Joe-Templet/STJ-Designs/Projects/2003-v1/WaferLayout_Chips_Chosen.pdf

2x3 - 196
3x3 - 130
10x10 - 44
1] | (2) | 12mm from center
2a] (6+3) (2/3)mm pitch (above/below) center 2b] (32) 3mm pitch
3] (8x4) 10mm x 10mm pitch (maybe 2 steps?)
