Joe-Templet/STJ-Designs/Reference/Design/32-130-B.png

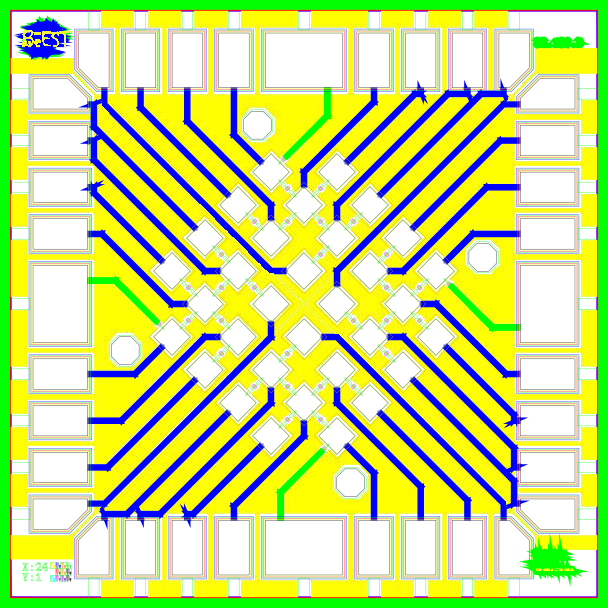
Reference/Design/32-130-B.png
