Joe-Templet/STJ-Designs/Reference/Design/128-200-B.png

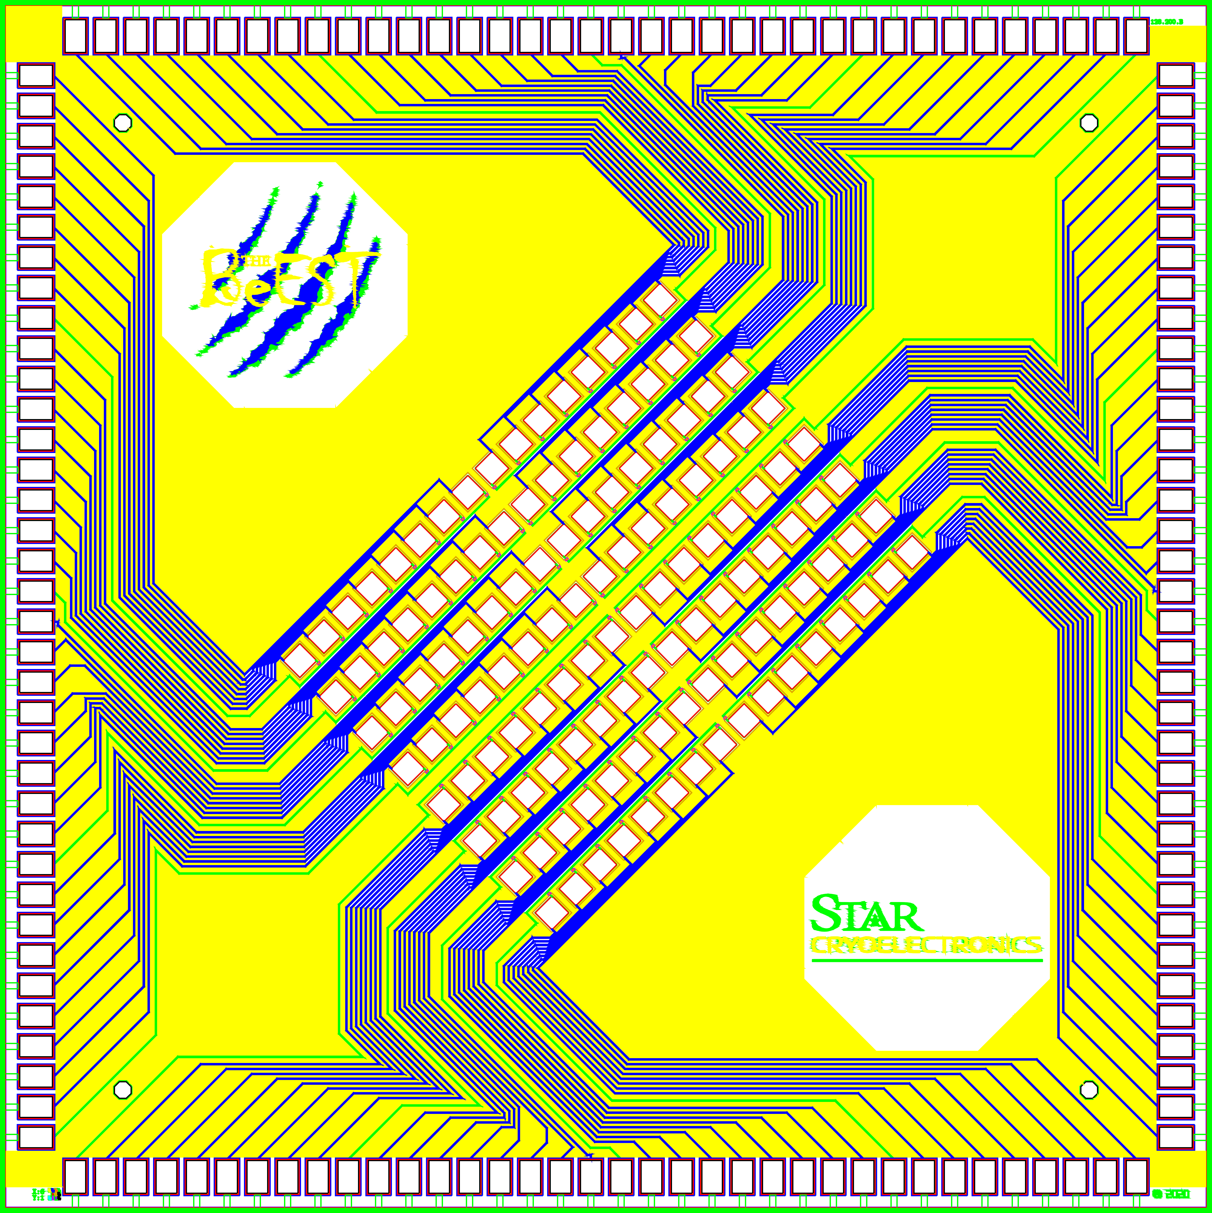
Reference/Design/128-200-B.png
