Joe-Templet/STJ-Designs/Reference/Design/TC-B.png

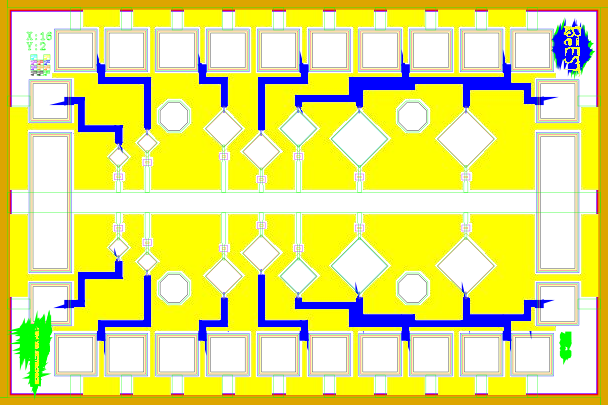
Reference/Design/TC-B.png
