Joe-Templet/STJ-Designs/Reference/Cell List.xlsx

Name | Prefix | Multiplicity | Subsystem 1 | Subsystem 2 | Core | Size | Feature | C1 | C2 | C3 | C4 | C5 | Feature Set | Notes
$128_70 | $ | 128 |  |  |  | 70 |  | 70 | 70 | 70 | 70 | 128_70 | A | (A)bsorber on pixels
$128_70A | $ | 128 |  |  |  | 70 | A | 70A | 70A | 70A | 70A | 128_70A | B | (B)eEST Logo on Chip
$128_70B | $ | 128 |  |  |  | 70 | B | 70B | 70B | 70B | 70B | 128_70B | C | Both A + B
$128_70C | $ | 128 |  |  |  | 70 | C | 70C | 70C | 70C | 70C | 128_70C | E | (Not Used) NO Membrane (E)tch
$128_130 | $ | 128 |  |  |  | 130 |  | 130 | 130 | 130 | 130 | 128_130 | F | (Not Used) NO (F)ield Area Au Fill
$128_130A | $ | 128 |  |  |  | 130 | A | 130A | 130A | 130A | 130A | 128_130A | P | (Not Used) SiO2 (P)atches
$128_130B | $ | 128 |  |  |  | 130 | B | 130B | 130B | 130B | 130B | 128_130B | S | (Not Used) Full (S)iO2 Edge Coverage
$128_130C | $ | 128 |  |  |  | 130 | C | 130C | 130C | 130C | 130C | 128_130C
$128_200 | $ | 128 |  |  |  | 200 |  | 200 | 200 | 200 | 200 | 128_200
$128_200A | $ | 128 |  |  |  | 200 | A | 200A | 200A | 200A | 200A | 128_200A
$128_200B | $ | 128 |  |  |  | 200 | B | 200B | 200B | 200B | 200B | 128_200B
$128_200C | $ | 128 |  |  |  | 200 | C | 200C | 200C | 200C | 200C | 128_200C
$32_70 | $ | 32 |  |  |  | 70 |  | 70 | 70 | 70 | 70 | 32_70
$32_70A | $ | 32 |  |  |  | 70 | A | 70A | 70A | 70A | 70A | 32_70A
$32_70B | $ | 32 |  |  |  | 70 | B | 70B | 70B | 70B | 70B | 32_70B
$32_70C | $ | 32 |  |  |  | 70 | C | 70C | 70C | 70C | 70C | 32_70C
$32_130 | $ | 32 |  |  |  | 130 |  | 130 | 130 | 130 | 130 | 32_130
$32_130A | $ | 32 |  |  |  | 130 | A | 130A | 130A | 130A | 130A | 32_130A
$32_130B | $ | 32 |  |  |  | 130 | B | 130B | 130B | 130B | 130B | 32_130B
$32_130C | $ | 32 |  |  |  | 130 | C | 130C | 130C | 130C | 130C | 32_130C
$32_200 | $ | 32 |  |  |  | 200 |  | 200 | 200 | 200 | 200 | 32_200
$32_200A | $ | 32 |  |  |  | 200 | A | 200A | 200A | 200A | 200A | 32_200A
$32_200B | $ | 32 |  |  |  | 200 | B | 200B | 200B | 200B | 200B | 32_200B
$32_200C | $ | 32 |  |  |  | 200 | C | 200C | 200C | 200C | 200C | 32_200C
$TC | $ | TC |  |  |  |  |  |  |  |  |  | TC
$TC_B | $ | TC |  |  |  |  | B | B | B | B | B | TC_B
_128PADS | _ | 128 | PADS |  |  |  |  |  |  |  | PADS | 128PADS
_32PADS | _ | 32 | PADS |  |  |  |  |  |  |  | PADS | 32PADS
_128_PAD | _ | 128 |  |  | PAD |  |  |  | PAD | PAD | PAD | 128_PAD
_128_PAD | _ | 128 |  |  | PAD |  |  |  | PAD | PAD | PAD | 128_PAD
_ | _
_ | _
_ | _
_ | _
_ | _
_ | _
_ | _
_ | _
_ | _
_ | _
_ | _
_ | _
_ | _
_ | _
_ | _
_ | _
_ | _
_ | _
_ | _
_ | _
_ | _
_ | _
_ | _
_ | _
_ | _
_ | _
_ | _
_ | _
_ | _
_ | _
_ | _
_ | _
_ | _
_ | _
_ | _
_ | _
_ | _
_ | _
_ | _
