Joe-Templet/STJ-Designs/Reference/Fabrication/SAEP/Test Chip.dxf

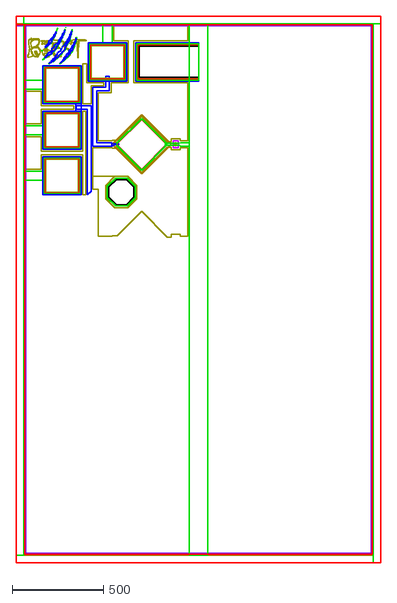
[picture p8: CAD file, 2024-06-13]
Reference/Fabrication/SAEP/Test Chip.dxf
2000.0 x 3000.0
