Joe-Templet/STJ-Designs/KLayoutEditor/Masks-Collimators.dxf

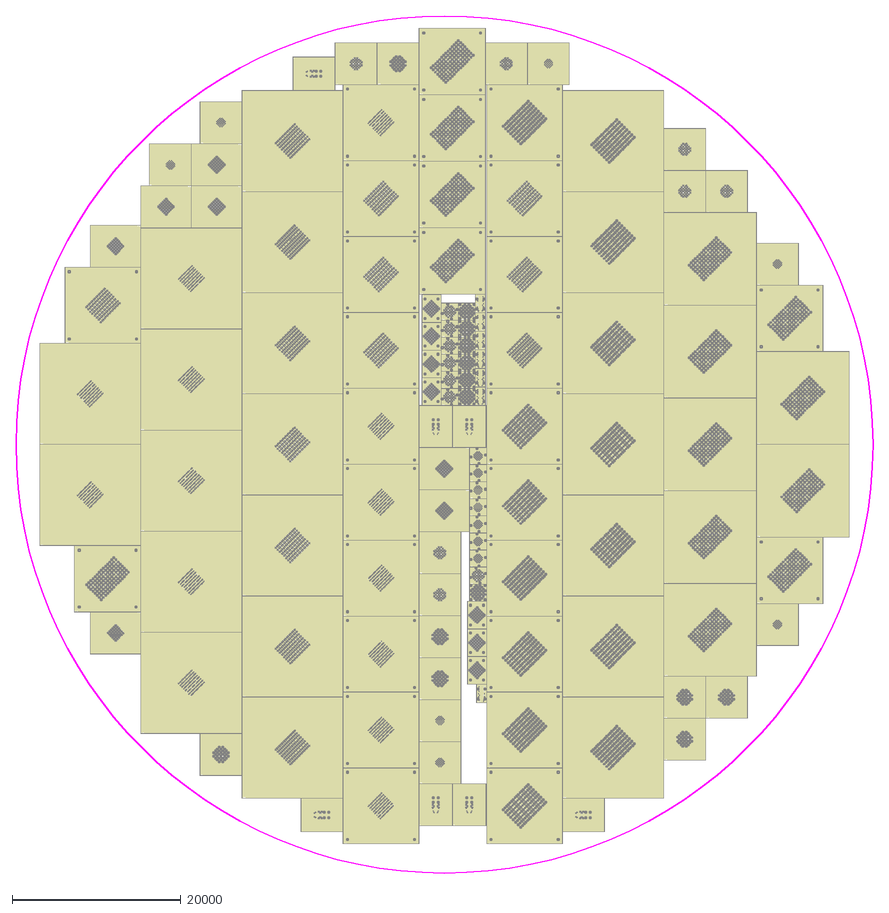
[picture p9: CAD file, 2024-06-13]
KLayoutEditor/Masks-Collimators.dxf
101600.0 x 101600.0
