Joe-Templet/STJ-Designs/(list of files, cad)

Other CAD files:
AutoCAD/Masks-Collimators.dwg
KLayoutEditor/Cells-Fabrication.dxf
AutoCAD/Masks-Encapsulation.dwg
AutoCAD/Cells-Fabrication.dwg
AutoCAD/Numbering.dwg
AutoCAD/STARCryo.dwg
AutoCAD/Cells-Collimators.dwg
Reference/Fabrication/SAEP/Test Chip.dwg
