Joe-Templet/STJ-Designs/Reference/Fabrication/Tolerances/STJ-XS_Tolerances.md

---
aliases: 
tags: 
---
# STJ-XS_Tolerances

#todo
- [ ] Add Nb plug and plug width (20 $\mu$m)
