Joe-Templet/STJ-Designs/Reference/Fabrication/Tolerances/STJ-XS_Tolerances.png.md

---
aliases: 
tags: 
type: file-note
cdate:  2023-10-09
idate:  2024-02-28
source: ""
---
# STJ-XS_Tolerances.png

![[6_History/BeEST-3DEV-Al_STJ/Planning/Tolerance Details/STJ-XS_Tolerances.png]]

## Backlinks

%% Points to the backlinks of the non-markdown file itself. Works excellent with images, need to test on any data type including those with possible editability %%

```dataview
table
where contains(file.outlinks, link(replace(this.file.path,".md","")))
where file.link != this.file.link
```
