Joe-Templet/STJ-Designs/Reference/Fabrication/SAEP/GDS Data/GDS1 Plug.jpg

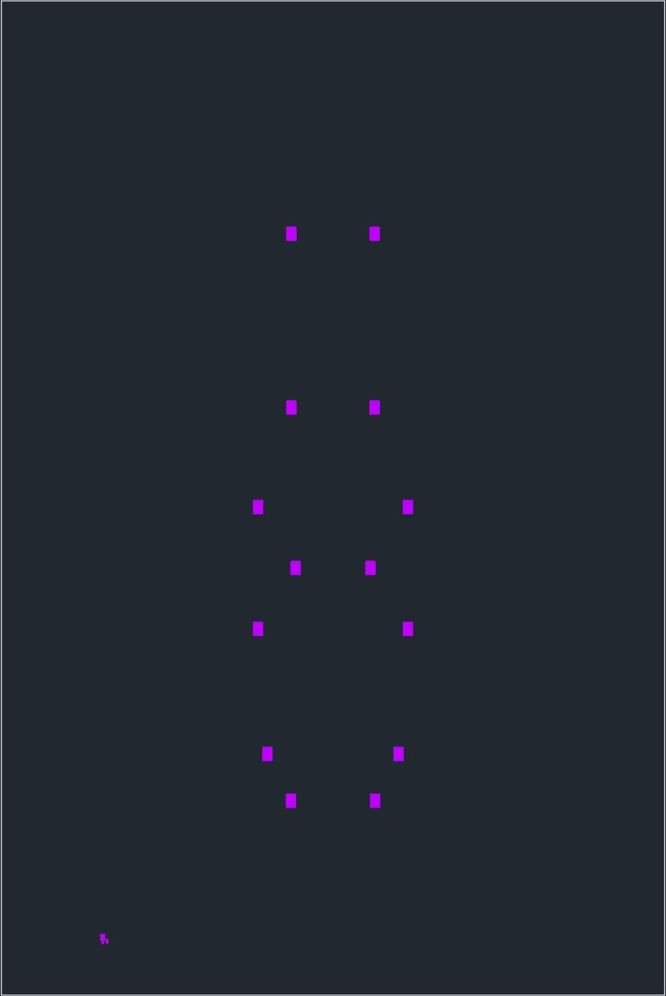
Reference/Fabrication/SAEP/GDS Data/GDS1 Plug.jpg
