Joe-Templet/STJ-Designs/Reference/Fabrication/SAEP/GDS Data/GDS3 Base.jpg

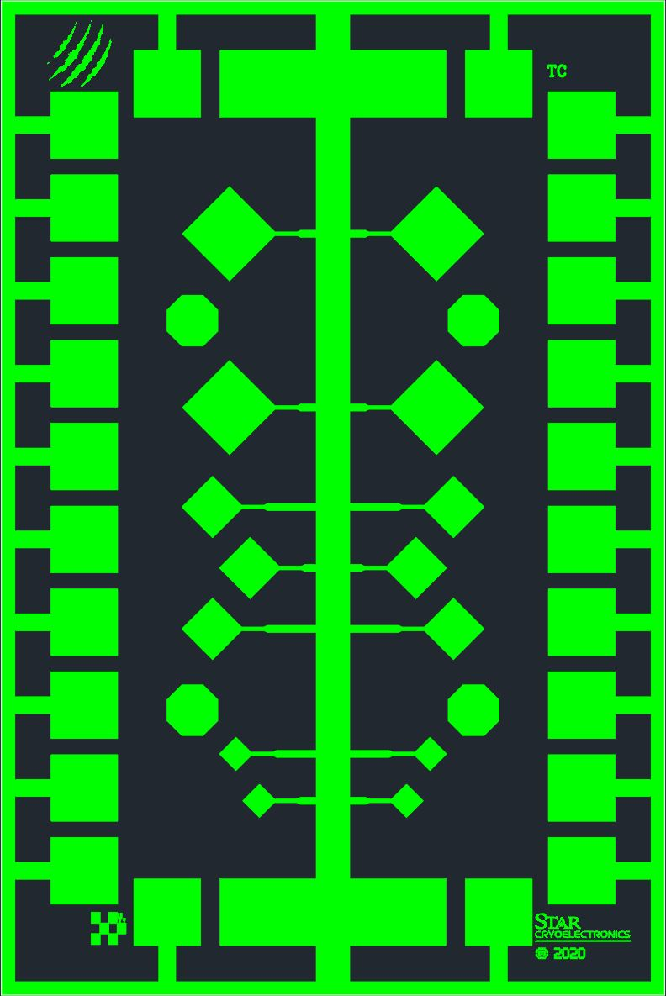
Reference/Fabrication/SAEP/GDS Data/GDS3 Base.jpg
