Joe-Templet/STJ-Designs/Reference/Fabrication/SAEP/GDS Data/GDS4 CNTR.jpg

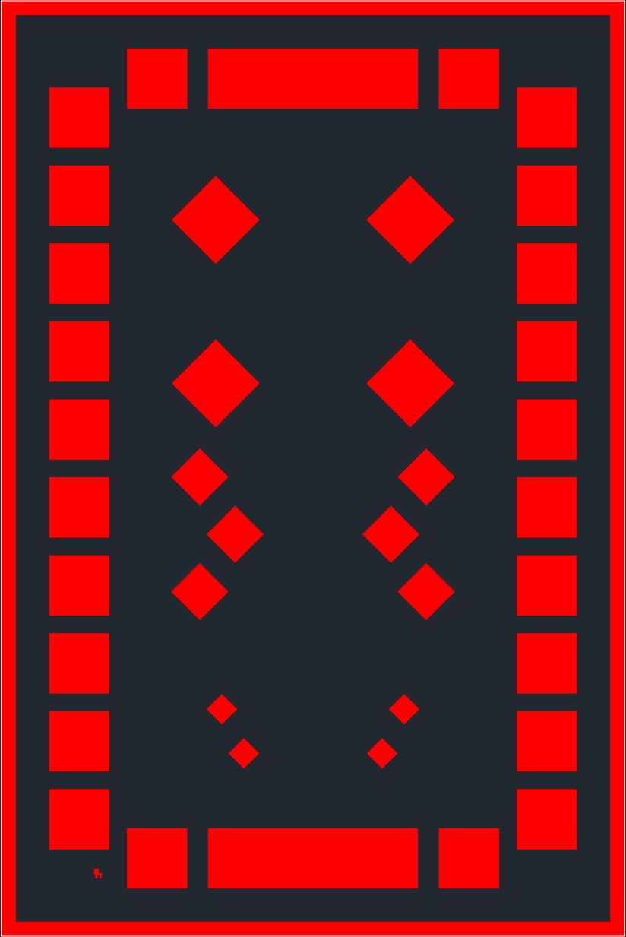
Reference/Fabrication/SAEP/GDS Data/GDS4 CNTR.jpg
