Joe-Templet/STJ-Designs/Reference/Fabrication/SAEP/GDS Data/GDS7 DE.jpg

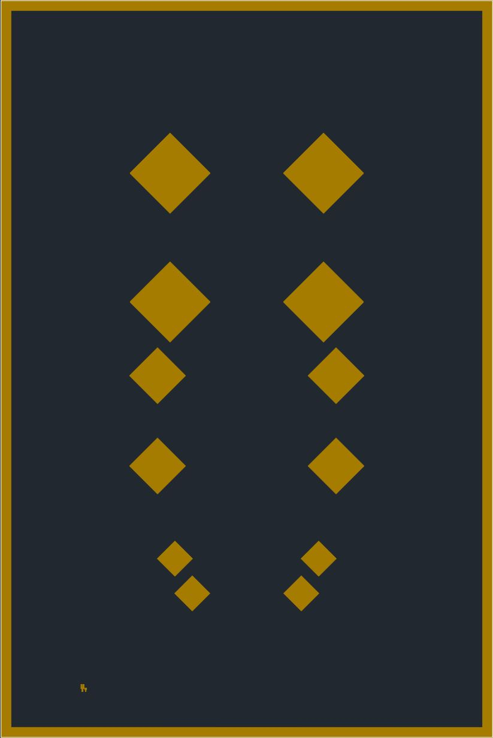
Reference/Fabrication/SAEP/GDS Data/GDS7 DE.jpg
