Joe-Templet/STJ-Designs/Reference/Fabrication/SAEP/GDS Data/GDS8 Wire.jpg

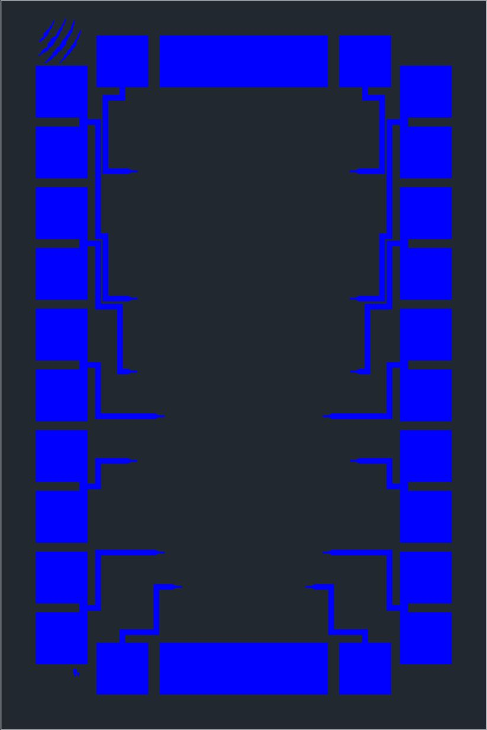
Reference/Fabrication/SAEP/GDS Data/GDS8 Wire.jpg
