Joe-Templet/STJ-Designs/Reference/Fabrication/SAEP/GDS Data/GDS9 Cont.jpg

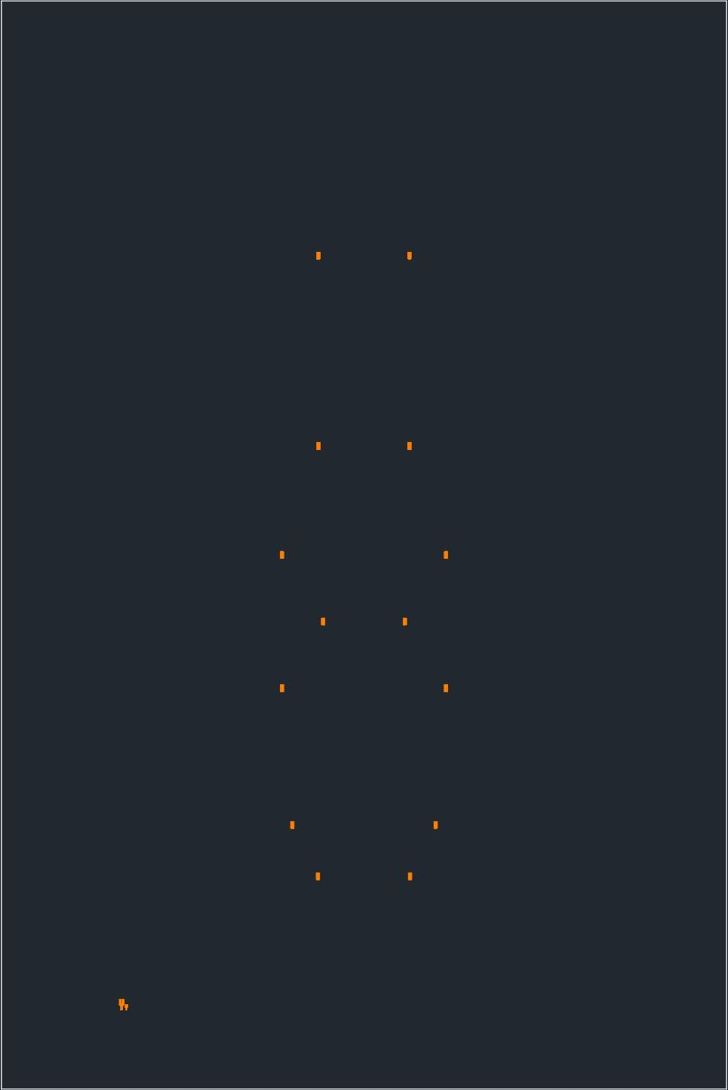
Reference/Fabrication/SAEP/GDS Data/GDS9 Cont.jpg
