Joe-Templet/STJ-Designs/Reference/Fabrication/SAEP/GDS Data/GDS10 ABS.jpg

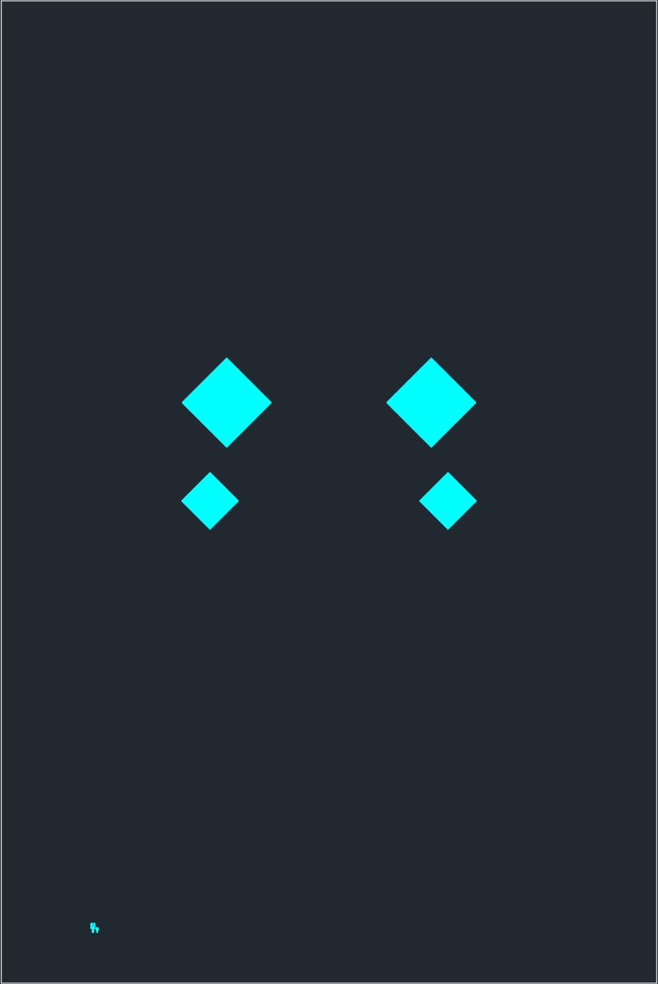
Reference/Fabrication/SAEP/GDS Data/GDS10 ABS.jpg
