Joe-Templet/STJ-Designs/Reference/Fabrication/SAEP/GDS Data/GDS12 Etch.jpg

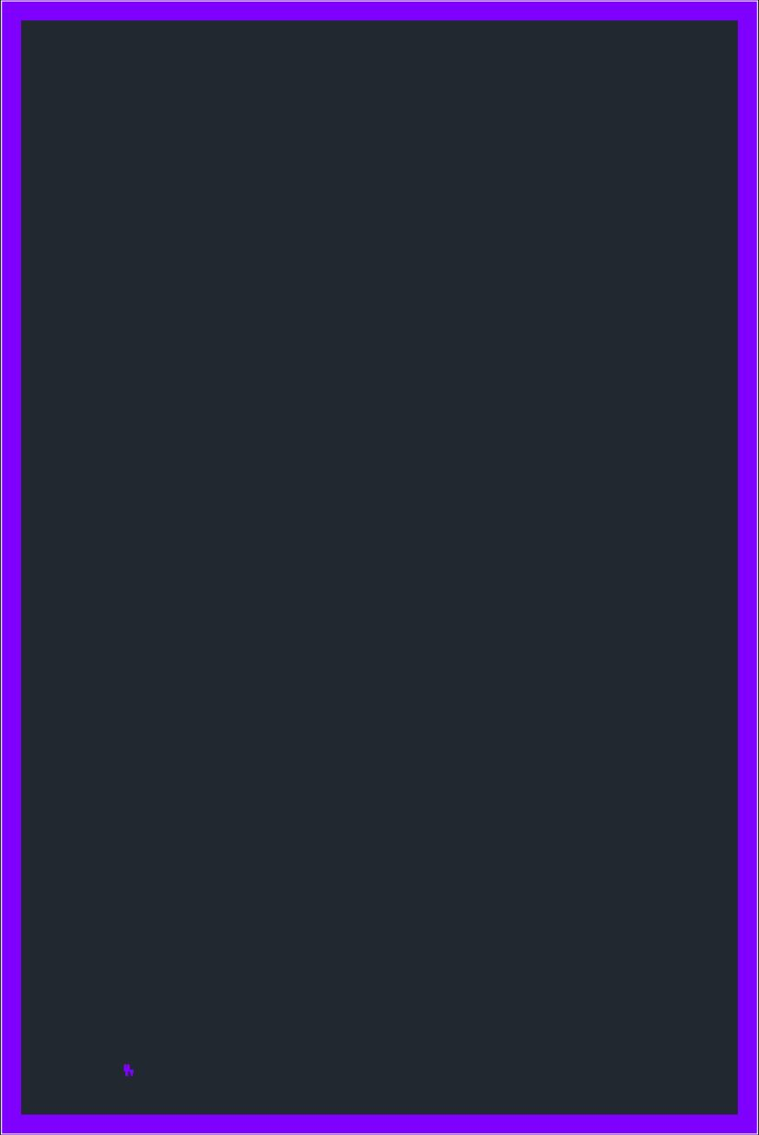
Reference/Fabrication/SAEP/GDS Data/GDS12 Etch.jpg
