Joe-Templet/STJ-Designs/Reference/Fabrication/SAEP/GDS Data/GDS14 Au.jpg

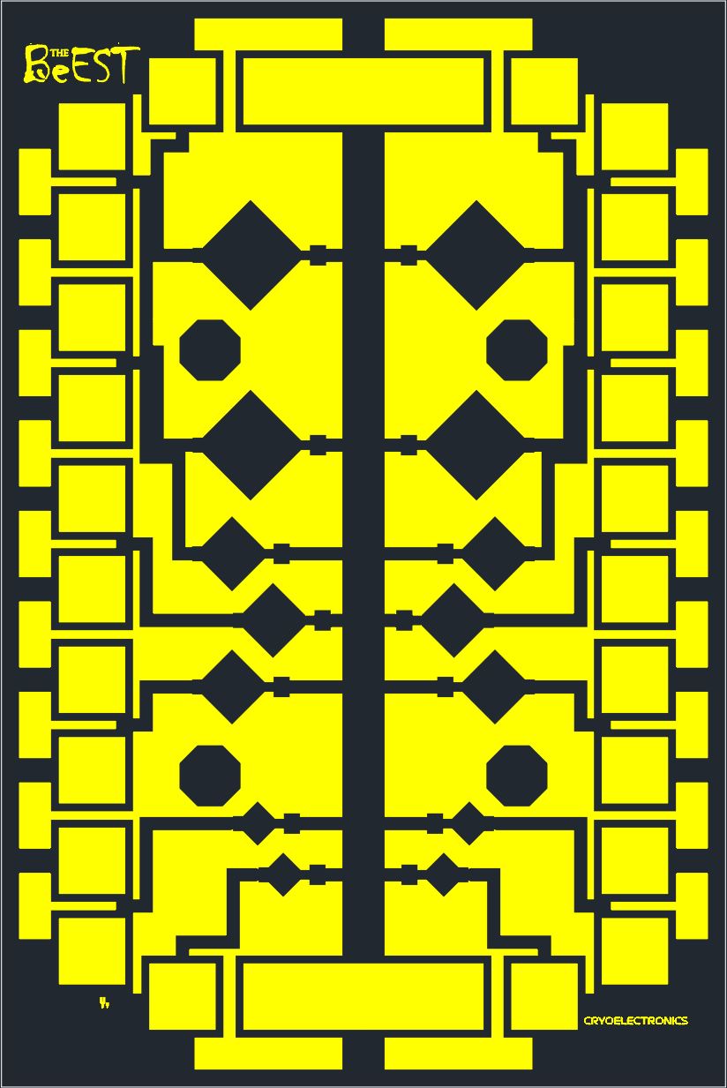
Reference/Fabrication/SAEP/GDS Data/GDS14 Au.jpg
