Joe-Templet/STJ-Designs/Reference/Fabrication/SAEP/GDS Data/GDS18+15 SU8+PVIA.jpg

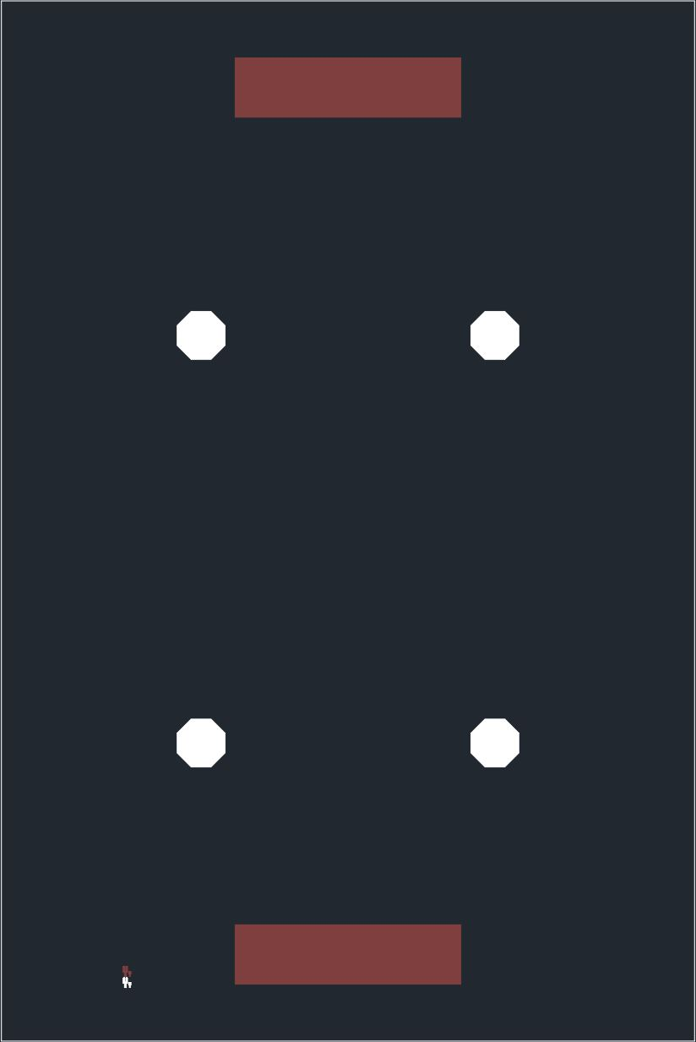
Reference/Fabrication/SAEP/GDS Data/GDS18+15 SU8+PVIA.jpg
