Joe-Templet/STJ-Designs/Reference/Fabrication/SAEP/GDS Data/GDS50 SiO2.jpg

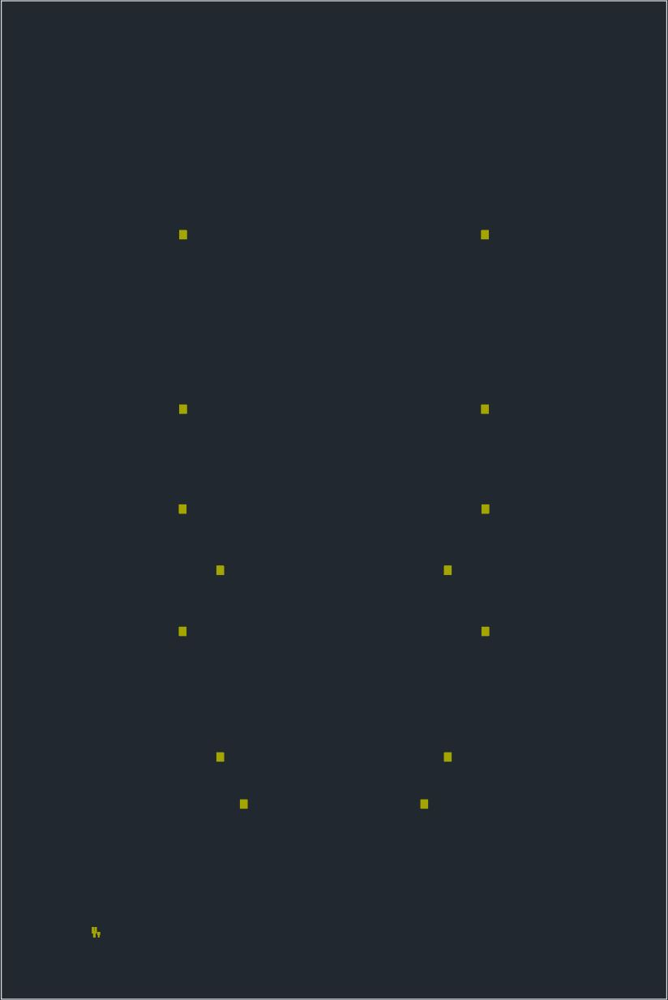
Reference/Fabrication/SAEP/GDS Data/GDS50 SiO2.jpg
