Joe-Templet/STJ-Designs/Projects/2003-v1/128_130_Full.pdf

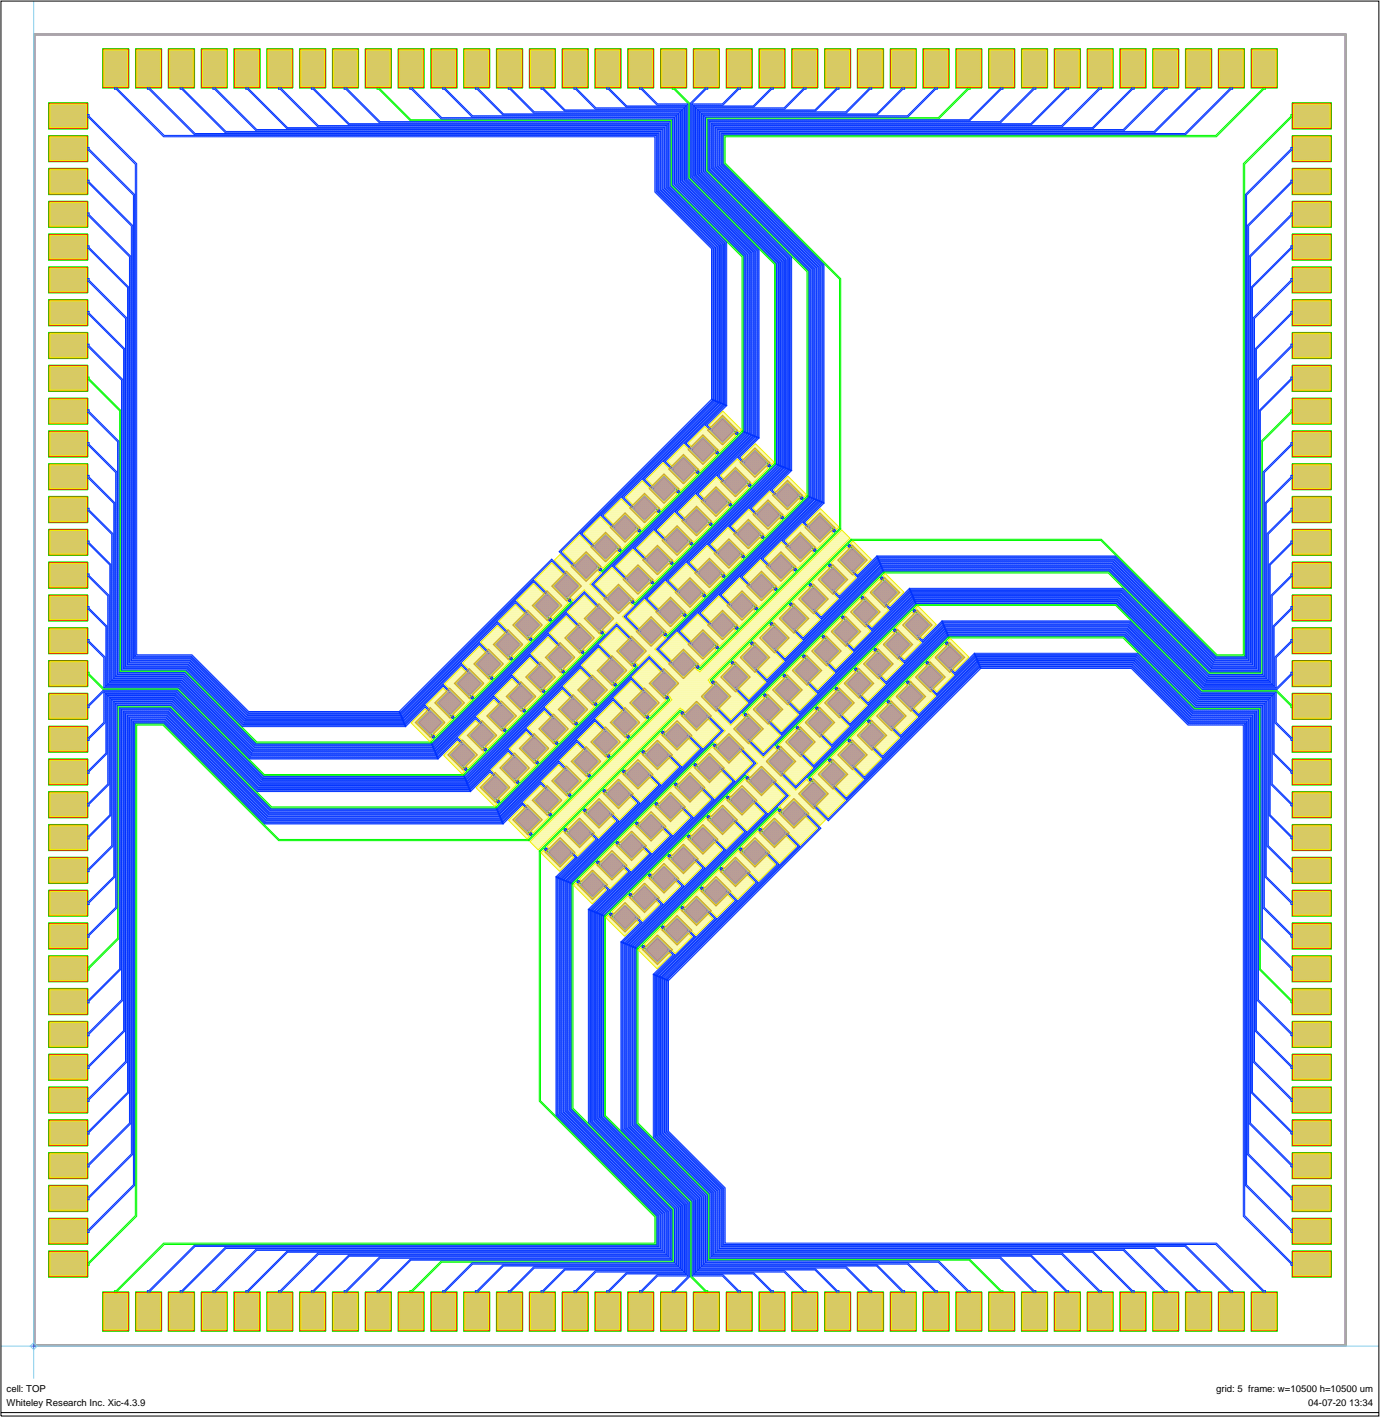
[picture p21: page 1]
cell: TOP; grid: 5 frame: w=10500 h=10500 um; Whiteley Research Inc. Xic-4.3.9
