Joe-Templet/STJ-Designs/Projects/2003-v1/128_70_Full.pdf

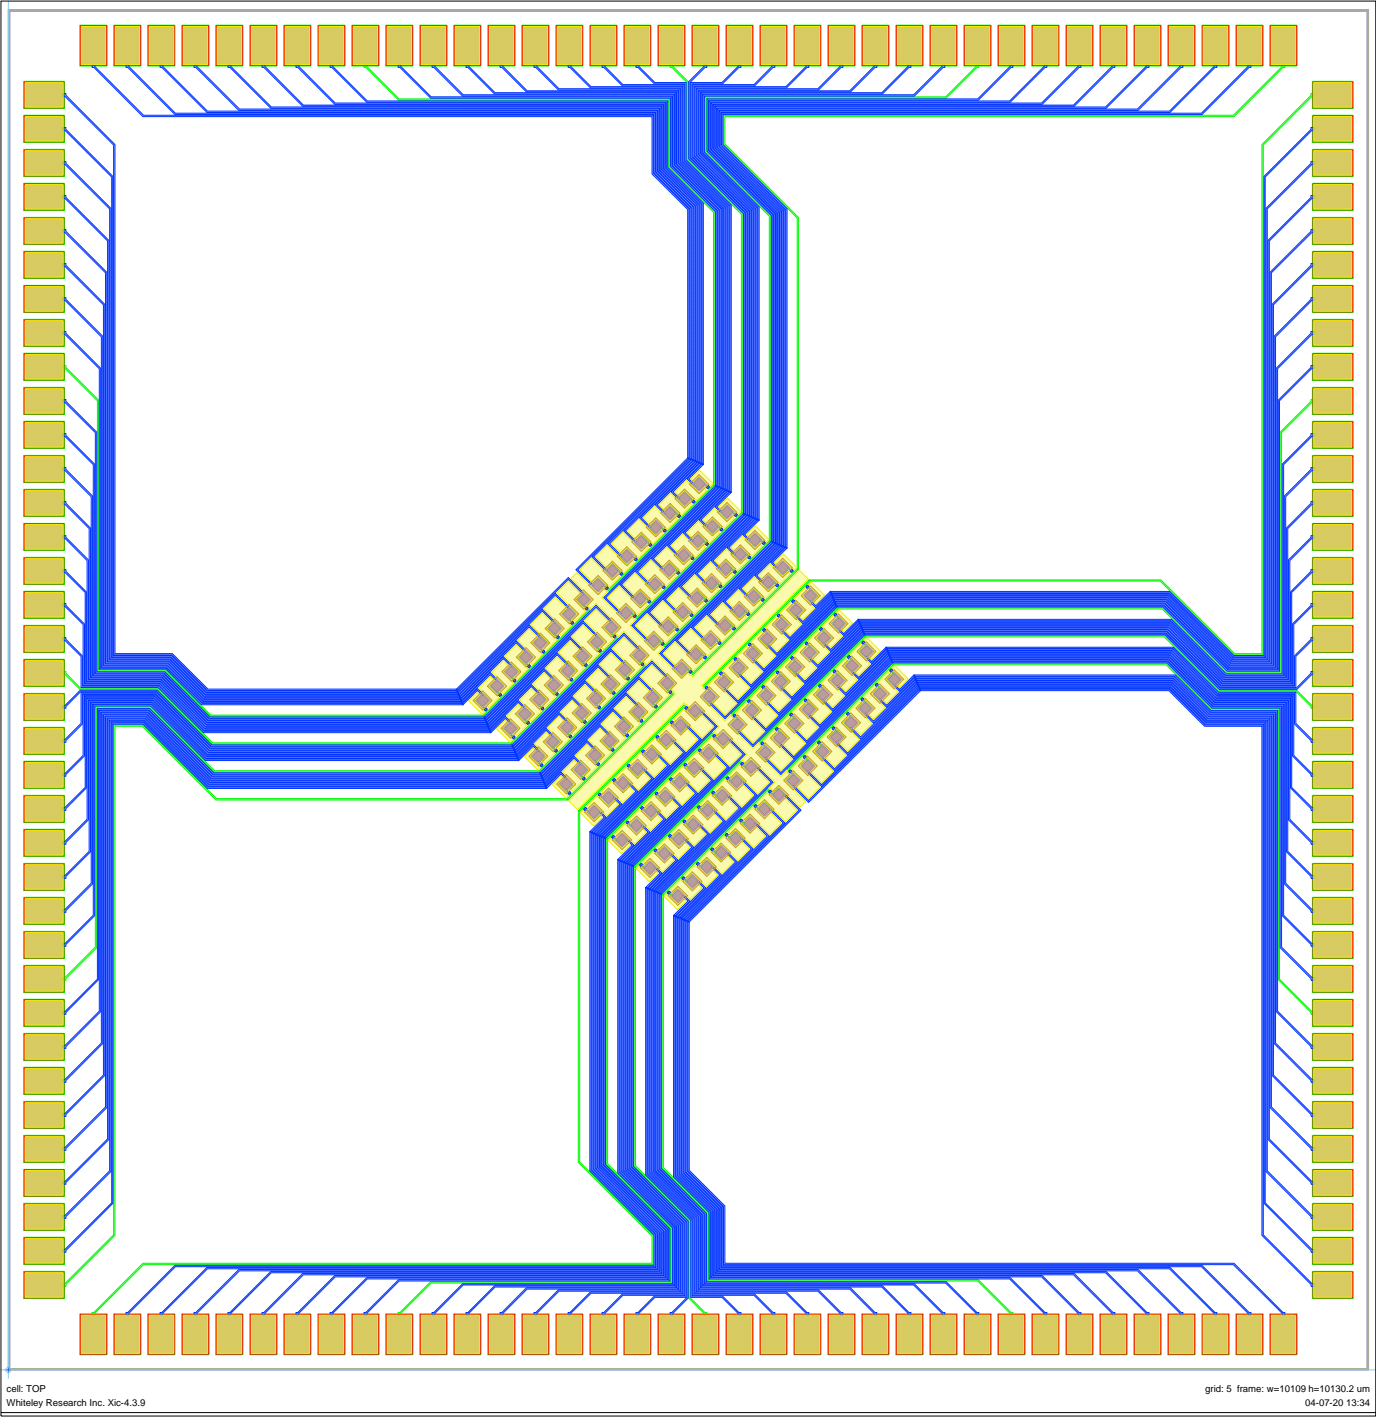
[picture p22: page 1]
cell: TOP; grid: 5 frame: w=10109 h=10130.2 um; Whiteley Research Inc. Xic-4.3.9
