Joe-Templet/STJ-Designs/Projects/2003-v1/36_130.pdf

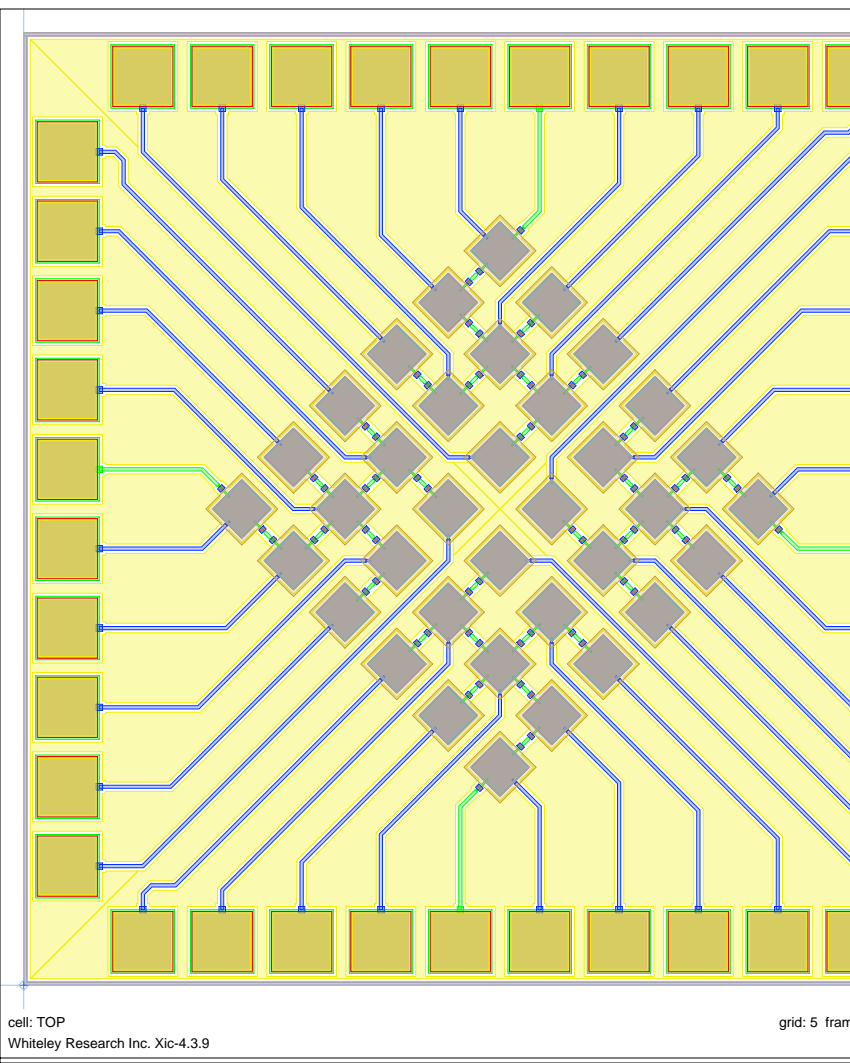
[picture p23: page 1]
cell: TOP; grid: 5 frame: w=3150 h=3150 um

Whiteley Research Inc. Xic-4.3.9
