Joe-Templet/STJ-Designs/Projects/2003-v1/36_70.pdf

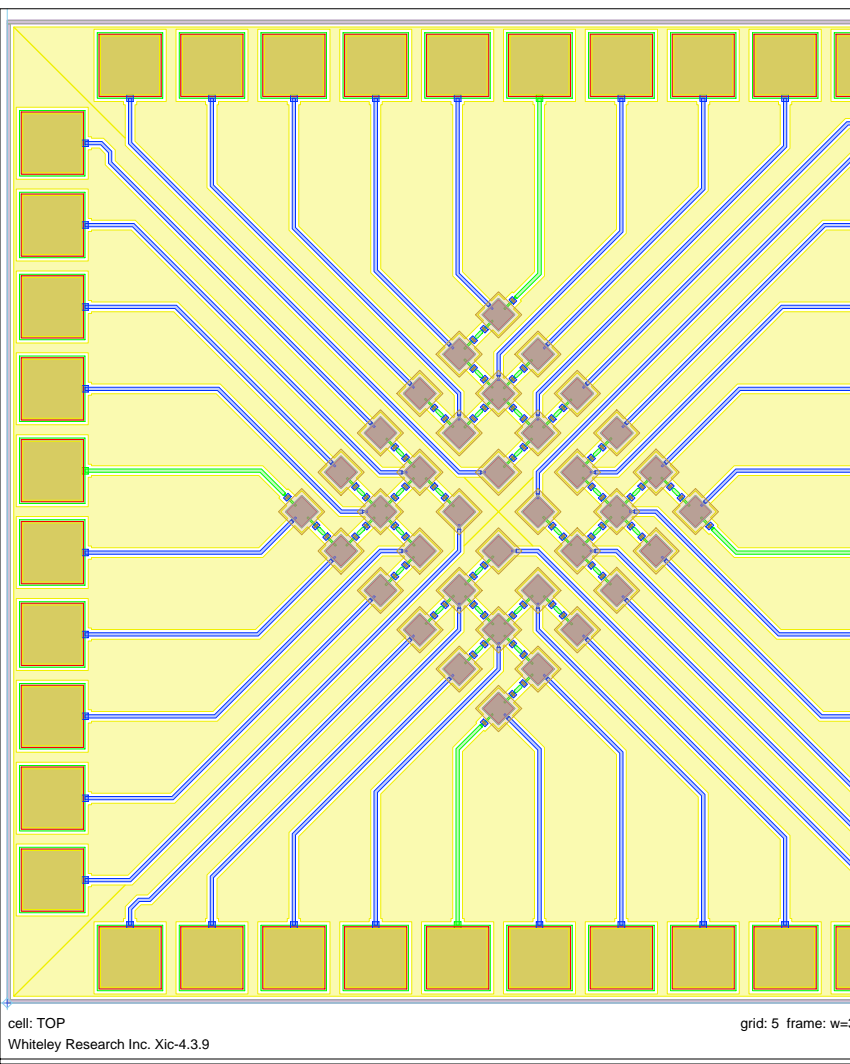
[picture p24: page 1]
cell: TOP; grid: 5 frame: w=3053.27 h=3057.67 um

Whiteley Research Inc. Xic-4.3.9
