Joe-Templet/STJ-Designs/Projects/2003-v1/Cell-TC-Fab.pdf

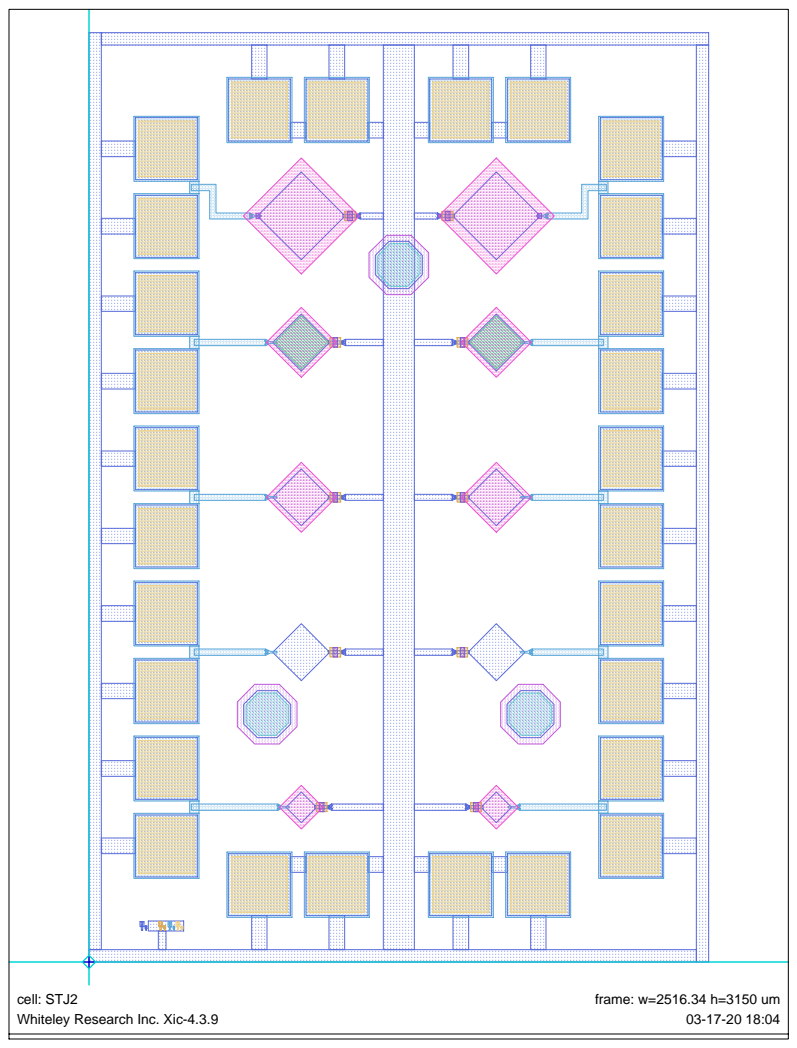
[picture p27: page 1]
cell: STJ2; frame: w=2516.34 h=3150 um; Whiteley Research Inc. Xic-4.3.9
