Joe-Templet/STJ-Designs/Projects/2003-v1/TC_Draft_2.pdf

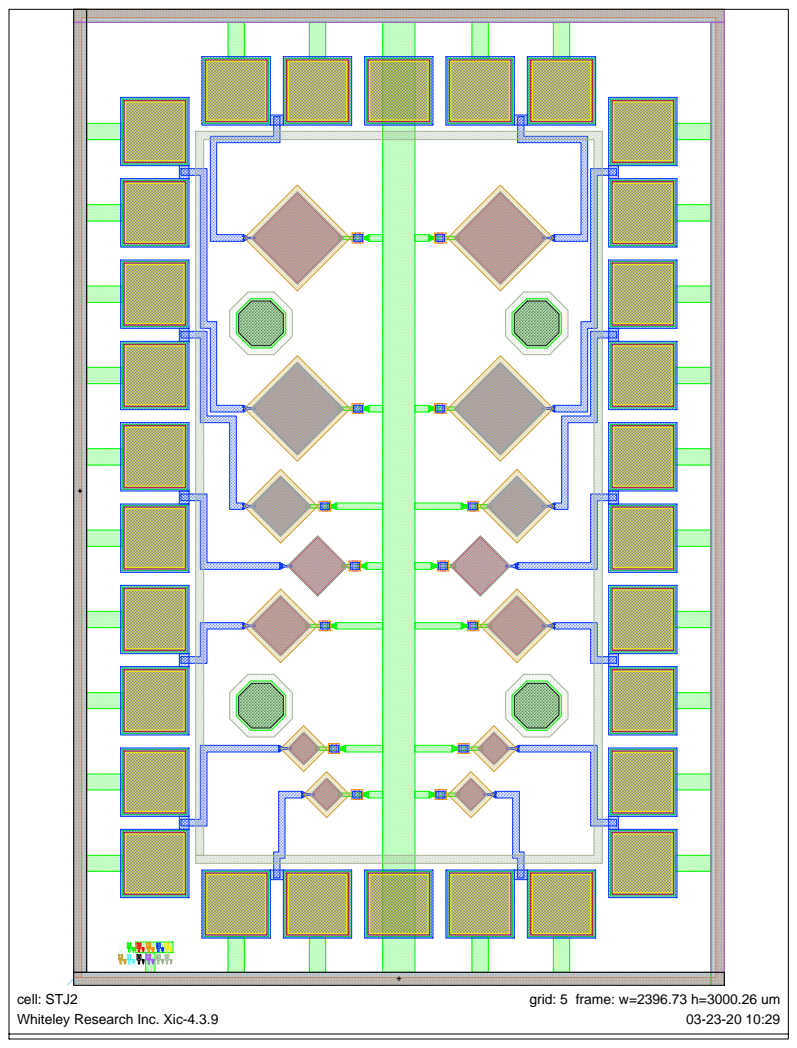
[picture p28: page 1]
cell: STJ2; grid: 5 frame: w=2396.73 h=3000.26 um; Whiteley Research Inc. Xic-4.3.9
