Joe-Templet/STJ-Designs/Projects/2003-v1/TC_Draft_2_Col.pdf

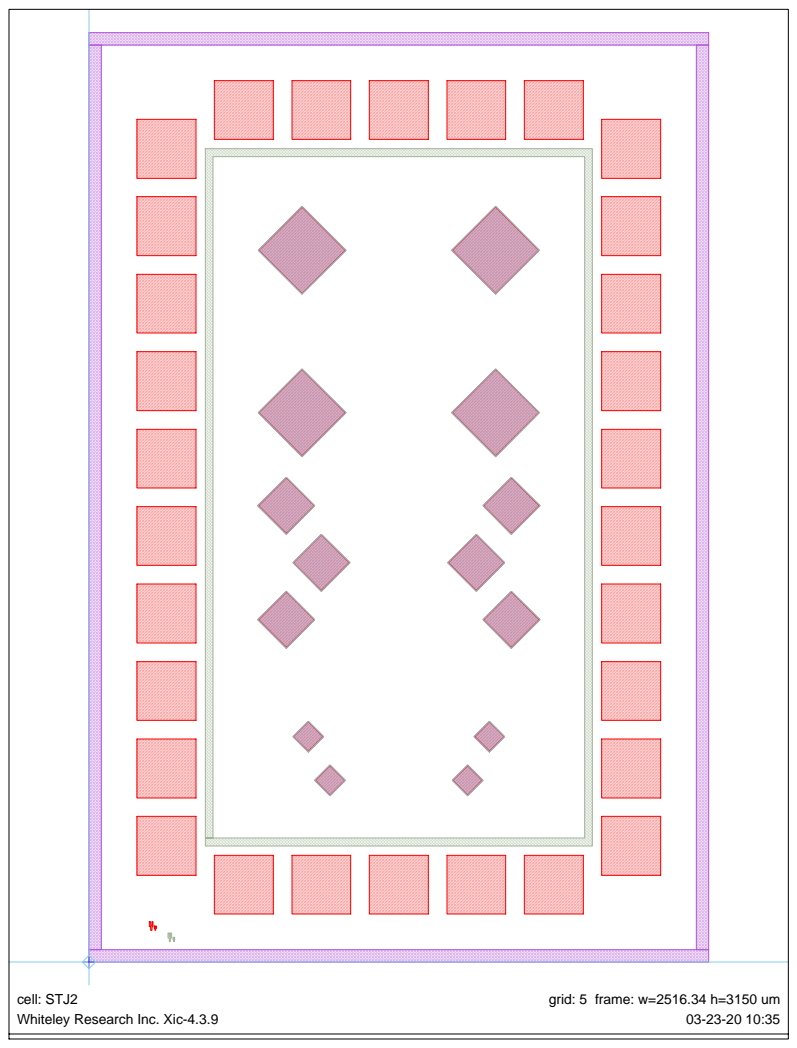
[picture p29: page 1]
cell: STJ2; grid: 5 frame: w=2516.34 h=3150 um; Whiteley Research Inc. Xic-4.3.9
