Joe-Templet/STJ-Designs/Projects/2003-v1/Array_128_70.pdf

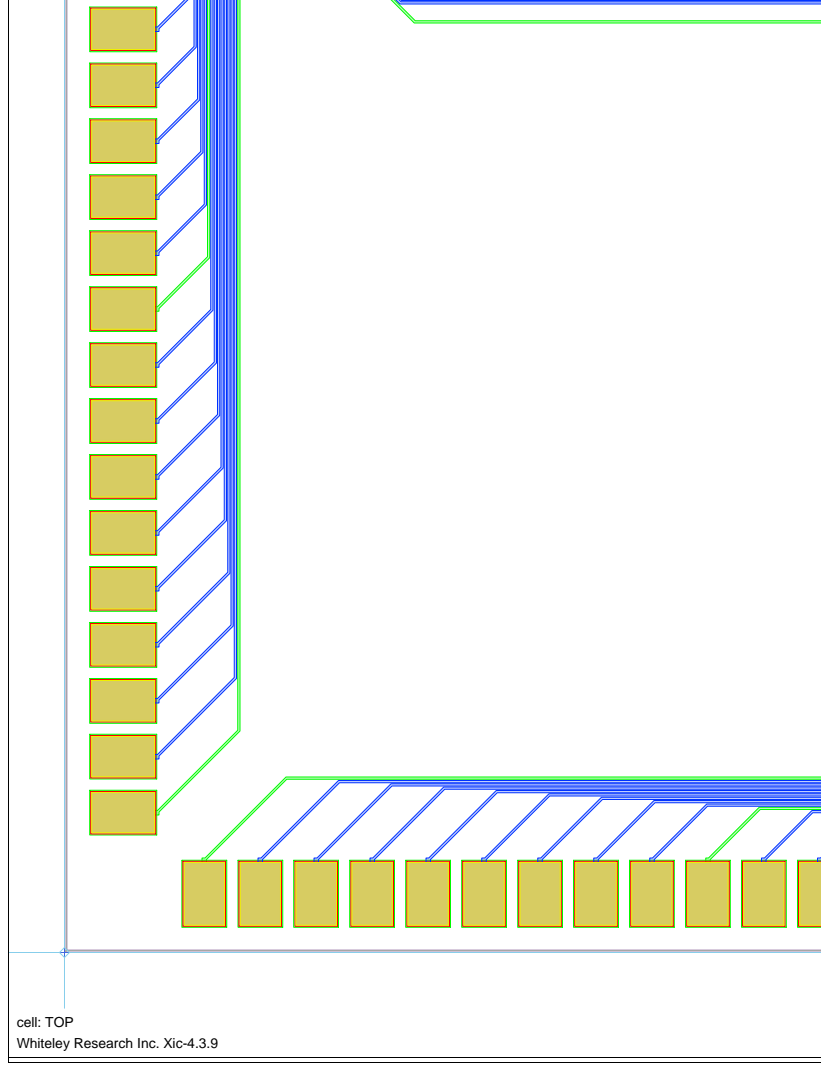
[picture p32: page 1]

cell: TOP
Whiteley Research Inc. Xic-4.3.9
