Joe-Templet/STJ-Designs/(commit log)

2024-06-13 Second Commit
    [Cell List.xlsx, Cells-Collimators.dwg, Cells-Fabrication.dwg, Cells-Fabrication.dxf, Masks-Collimators.dwg, Masks-Collimators.dxf, Masks-Encapsulation.dwg, Numbering.dwg]
2024-06-13 Outline of Quadrant Wires
2024-06-18 quadrant signal wires done (6-18-24)
2024-06-18 Trace is Donegit status
2024-06-19 All wires are merged and defined in quadrant cell
2024-06-26 Midpoint in the redesign of signal wires-Boarding Plane (6/26/24)
2024-07-01 The wires on the first file are wonky. The new file should be more consistant.
2024-07-01 Final stage before gold patterning
2024-07-05 moved SU8 posts away from wires
2024-07-16 TestChip Redesign. At this Commit, the trace is avalible on the top cell and the trace subcell. 7/16/24
2024-07-16 Redesigned Tst chip. Both Current and previous versions located in this file. The new design is located in the full wafer design layout. (7/15/24)-During Flight
2024-07-17 edited test chip boarders to be accurate and not have datat points off by nanometers.
2024-08-13 first edition of wires. Saving this form here but plan on redoing wire paths.
2024-08-19 Fixed Bondpad grouping into quadrants/rows. New wiring layout started and to be further continued. (8/19)
2024-08-25 Quadrant wires finished. Now need to establish quadrant cell. (8/25/24)
2024-09-01 wires done
2024-09-02 wires added but still a work in progress. Correct dimentions and add final wires.
2024-09-04 Layout/trace Done. Just pattern gold and add logos+allingment marker.
2024-09-04 Lots of Work Done. all 64 pixel chips are made. Just need to format corners of 64 pixel chips, insert into full wafer file, introduce allingment mark cell, and repattern the wafer per stephan and rob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
2024-09-27 Mesh Mask Design. Figure out how to pattern Circularly for all the small holes. Base Circles Created with 500 points per circle. Is this good enough?
2024-10-05 Chips moved around such that they fit withing 48mm radius circle. Deleted 2 of the bottom 64's to make room. This commit still has the 48mm circle.
2024-10-14 Re-centered chip as per robins request. Here, the x=0 lies between the middle 128s and the point at where that middle line and the line seperating the y=1 and y=2 128s meet has coordinates (0,10100).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
